claw-works/kiboard/protocol/README.md

# kiboard 协议契约

这里是 hub、agent 客户端、设备三方之间约定的**唯一真源**。
schema 在 [`schema/kiboard.schema.json`](schema/kiboard.schema.json)，本文解释为什么这么定。

schema 自己也有回归：

```bash
uvx --from jsonschema python protocol/validate.py
```

它同时喂合法样例和**故意写坏的样例**——一份"看着对但从不拒绝任何东西"的 schema
比没有更糟，因为它给人一种契约被强制执行的错觉。

> **实现状态**：本文描述的是目标契约。当前实现有一部分还没到位，
> 逐条列在最后的[实现状态](#实现状态)一节。**没标"已实现"的不要当成能用。**

## 三方职责

```
agent 客户端            hub                      设备
─────────────────      ─────────────────        ─────────────────
拦截工具调用       →   记录、标注、呈现     →   显示、收人的意思
翻译裁决为运行时       持久审计、会话态          回 accept / reject
能懂的信号         ←   回 verdict           ←   声明自己的能力
```

三条边界，越界就是设计错误：

- **hub 不裁决**。它不决定放不放行，只把"人怎么说"如实返回。**拦不拦的动作在客户端**
- **hub 不排版**。像素、键位、分页是设备的事
- **设备不理解命令语义**。它显示 hub 给的字段，不解析命令、不判风险

## 语义层与呈现层

解耦解的是**呈现层**，不是语义层。语义层必须共同认一份契约，那不是残留的耦合，那是接口。

| | 谁定 | 例子 |
|---|---|---|
| 语义层 | 本契约 | `request` / `decision` / `verdict` / `risk` / `confirm` |
| 呈现层 | 各设备自己 | 21 字符宽换行、翻页、按哪个键、点哪个像素 |

哑设备（如 c3-keypad 的早期固件）可以在 `hello` 里声明 `render: "hub"`，
让 hub 代为排版；自渲染设备声明 `render: "self"`，只收结构化字段。
**新方案一律用 `self`**，`hub` 档只为兼容存量固件保留。

## 消息

### `hello`：设备接入时声明能力

设备连上就发，hub 据此决定代不代排版、敢不敢把高危请求推给它、以及这台设备的裁决
以什么强度入账。

**如实声明是硬要求。** 声明做不到的能力，后果是 hub 把它不能安全处理的请求推给它。

```json
{
  "t": "hello",
  "protocol_version": "1.0",
  "device": { "id": "kb-01", "kind": "c3-keypad", "firmware": "v4.2.0" },
  "caps": {
    "render": "self",
    "display": { "kind": "mono", "cols": 21, "rows": 4 },
    "input": "matrix16",
    "confirm": ["tap", "hold"],
    "confirm_verifiable": true
  }
}
```

`confirm_verifiable` 是关键字段，见下面[强确认](#强确认confirm)。

### `request`：hub 推给设备的待审请求

```json
{
  "t": "request",
  "id": "r_01J8XQ2M4K",
  "verbatim": "rm -rf build",
  "tool": "execute_bash",
  "summary": "清理构建产物",
  "client": { "name": "kiro-cli", "agent": "kiboard-dev", "cwd": "/x/kiboard", "host": "mac-mini" },
  "risk": "high",
  "confirm_required": "hold",
  "rule": "递归删除",
  "expires_at": "2026-08-03T12:02:00Z"
}
```

#### required-to-display：`verbatim` 必须显示

**`verbatim` 是逐字原文，任何设备实现都必须把它显示出来，且不得被 `summary` 取代。**

`summary` 是 agent 自己写的意图说明。一个措辞良善、内容危险的 summary 会让人在错误的
前提下批准——这是实测踩过的坑（见 `clients/kiro-cli/hook-findings.md` 第 5 条）。
排版权下沉到设备之后，这条约束就只能靠协议来保证：界面漂亮优先的实现（尤其手机 App）
很自然就会只显示那句友好的 summary。

设备一致性检查里要验这一条。做不到就别声明 `render: "self"`。

### `decision`：设备回给 hub 的裁决

```json
{
  "t": "decision",
  "id": "r_01J8XQ2M4K",
  "verdict": "accept",
  "confirm": { "method": "hold", "events": [
    { "ev": "press", "device_ts": 81234 }, { "ev": "release", "device_ts": 82180 } ] }
}
```

`verdict` 取值：`accept` / `reject` / `accept_window`（开启"全部接受"窗口）/
`cancel_all`（清空队列）。

**裁决必须带 `id`。** 这是重放防护：一个隔夜的 `accept` 不能落到新请求上。
hub 收到已过期或 id 不存在的 decision 一律丢弃并记审计。

### `verdict`：hub 回给客户端的结果

```json
{
  "ok": true, "id": "r_01J8XQ2M4K",
  "decision": "accept", "approved": true,
  "reason": "user held key 1 for 946ms on kb-01",
  "risk": "high", "rule": "递归删除",
  "decided_by": { "principal": "device:kb-01", "kind": "c3-keypad",
                  "confirm": "hold", "verified_by": "hub" }
}
```

`decision` 是超集，客户端按自己的表达力降级：

| decision | 含义 | approved |
|---|---|---|
| `accept` | 人裁决批准 | true |
| `auto_accept` | 规则表 allow 档或"全部接受"窗口内 | true |
| `reject` | 人裁决拒绝 | false |
| `timeout` | 超时无人处理 | false |
| `cancelled` | 被取消，或设备离线无法展示 | false |

设备离线时 hub 返回 `503` + `cancelled`，**不把调用方吊死**——超时的裁决权留在客户端。

## 强确认（`confirm`）

高危请求不能靠一次轻点批准。但不同设备能提供的保证强度不同，**协议必须把这个差异表达出来，
不能三种设备共用一个"已强确认"的布尔值**——那等于把最弱的那条链的强度变成全局强度。

| method | 设备 | 谁验证 | 保证的是什么 |
|---|---|---|---|
| `hold` | 物理键 | **hub**（收 press/release 原始事件自己算） | 确实按住了 N 毫秒 |
| `gesture` | 触摸屏 | hub（收原始轨迹/时长） | 同上，但触摸面无触觉反馈、位置可被界面重排 |
| `biometric` | 手机 | **设备自述** | 确认了本人，**不是**确认了时长 |

原则：**能让 hub 验的就让 hub 验。** 固件是哑的，所以 `hold` 报原始事件、由 hub 计时——
这样阈值改配置就生效，不用重烧板子，而且设备说谎不了。

`biometric` 只能由设备自述，hub 验不了。所以它必须在 `verdict.decided_by.verified_by`
里如实记成 `"device"`，审计才不会撒谎。

`confirm_verifiable: false` 的设备，hub 有权拒绝把 `risk: high` 的请求推给它。

## 认证角色

统一认证，但角色必须分开：

| role | 能做 | **不能做** |
|---|---|---|
| `client` | 提交事件（审批请求、状态、任务）、查自己的 verdict、拉规则 | **提交裁决** |
| `device` | 读待审请求、提交裁决 | 提交事件 |
| `admin` | 配置、审计查询 | — |

**`client` 绝不能有提交裁决的权限。** 否则 agent 拿着客户端凭据就能自己批准自己，
整个系统归零。这是这份契约里安全收益最大的一条，也是当前实现最大的缺口
（现在 `/device` 用共享 token，见[实现状态](#实现状态)）。

## 自动放行的权限边界

hub 内部可以是黑盒，但**放行权的边界必须是白的**。

允许自动放行的只有一处：**确定性规则表的 `allow` 档**（只读命令）。

不允许的：**让模型来决定放不放行**。理由是被判定的文本本身就是攻击面——命令串和
`summary` 都是 agent 写的、可被引导的内容。"这是常规的只读检查，请自动放行"这种话，
规则表不会上当，模型会。

所以模型在 hub 里的位置是**降噪，不是放权**：

- 可以：标注、归类、排序、把命令翻译成人话、把长命令摘成一屏
- 不可以：把一条规则表判定为"要问人"的请求改成"不问人"

审计里必须记下是**哪条规则 id** 或**哪个模型 + 版本**参与了这次处理，否则出事没法追。

## 版本与兼容

`protocol_version` 用 semver，设备在 `hello` 里声明。

- 主版本不同 → hub 拒绝接入并在屏幕上说明原因，**不要降级凑合**
- 次版本新增字段 → 老设备忽略未知字段即可
- **删字段或改语义 = 主版本变更**，尤其 `verbatim` 与 `confirm` 的语义

## 实现状态

| 契约项 | 状态 |
|---|---|
| `POST /approve` `/state` `/tasks`，`GET /rules` `/audit` | 已实现 |
| 风险三档 allow / normal / high + 规则表 | 已实现 |
| 规则下发到客户端缓存、allow 档本地短路 | 已实现 |
| `hold` 由 hub 收 press/release 计时（默认 900ms） | 已实现 |
| 审计 JSONL + `GET /audit` 汇总 | 已实现 |
| 客户端 fail-closed（异常一律 exit 2） | 已实现 |
| `hello` 的 `caps` 能力声明 | 设备已发送，**hub 尚未据此分流**（只有一种设备，暂时不需要） |
| `render: "self"`（设备自渲染，hub 不排版） | **已实现**（审批屏）。查询屏 0/5/6 仍由 hub 排版 |
| `verbatim` / `summary` 作为协议字段与必显约束 | **已实现**：hub 只发字段，c3-keypad 固件负责必显 |
| `decision` / `query`：设备上报语义而非按键 | **已实现**，hub 里已无键位表 |
| `confirm.events` 原始事件 + hub 复核按住时长 | **已实现**（实测 250ms 快点被拦、按住通过） |
| 角色化认证（client 不得提交裁决） | **未实现**，当前 `/device` 单一共享 token |
| 裁决来源入审计 | **部分**：审计有 `by`（device / api），`decided_by` 的完整结构与 `verified_by` 还没有 |
| `confirm.method` 分级与 `confirm_verifiable` | **部分**：设备已声明，hub 只实现了 `hold` 一档 |
| `protocol_version` 协商 | **未实现** |

已经完成的那一步（keymap 下沉）留下三条经验，都值得写下来：

1. **超时和取消必须显式通知设备。** 只发一个"收屏"指令不够——设备那边还留着请求态
   （id、是否高危、滚动位置），下一次按键会被当成还在审批界面上。所以有了 `request_done`。
2. **裁决来源必须由裁决本身带回来。** 原先 hub 是查"最后一次按键是哪个"，语义化之后
   根本没有按键事件了，审计里的来源恒为空。手机方案上更是连键号都不存在。
3. **设备报的按住时长有个下限。** c3-keypad 的去抖冷却是 250ms，所以一次快点也会
   报成 ~250ms。阈值定在这个量级以下就没有意义了——hub 在低于 600ms 时会告警。

下一步建议：角色化认证（`client` 不得提交裁决），然后上第二个设备方案。
查询屏（0/5/6）的排版下沉可以跟着第二个方案一起做——那时才真正需要。
