claw-works/kiboard/devices/c3-keypad/hardware/bom/00.webp

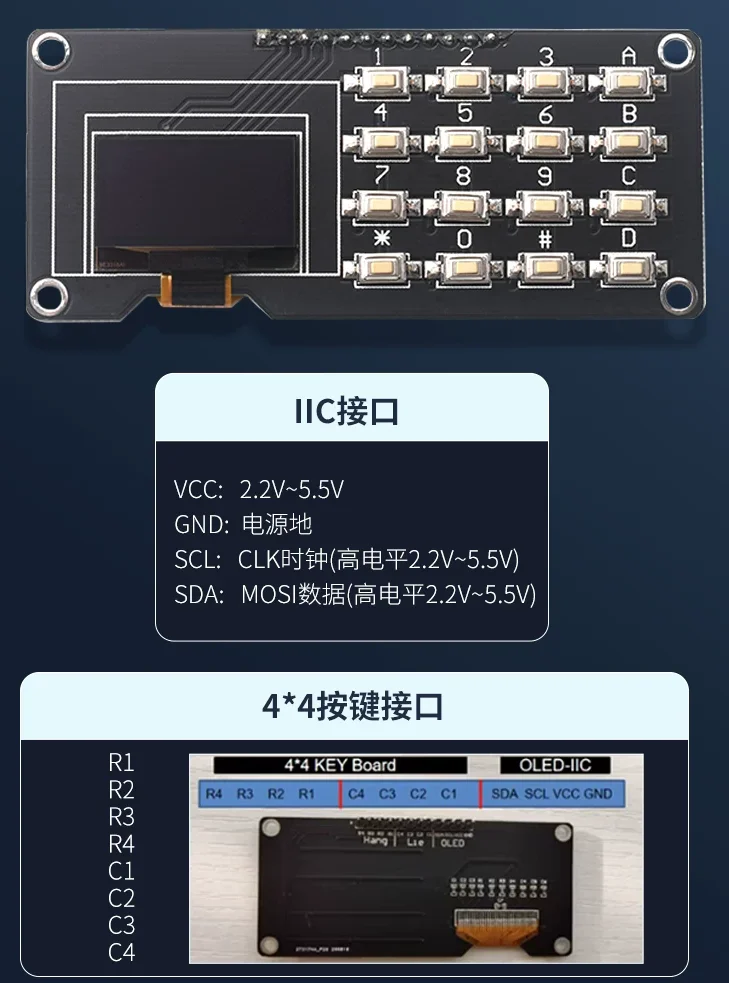
devices/c3-keypad/hardware/bom/00.webp
