claw-works/kiboard/devices/c3-keypad/hardware/bom/01.webp

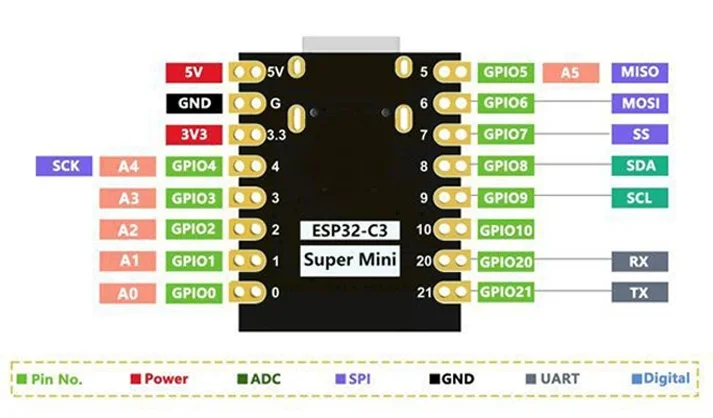
devices/c3-keypad/hardware/bom/01.webp
