claw-works/kiboard/devices/c3-keypad/hardware/kiboard/kiboard.kicad_pcb

## KiCad design hardware/schematic/SSVEP_Panel/SSVEP_Panel.kicad_sch

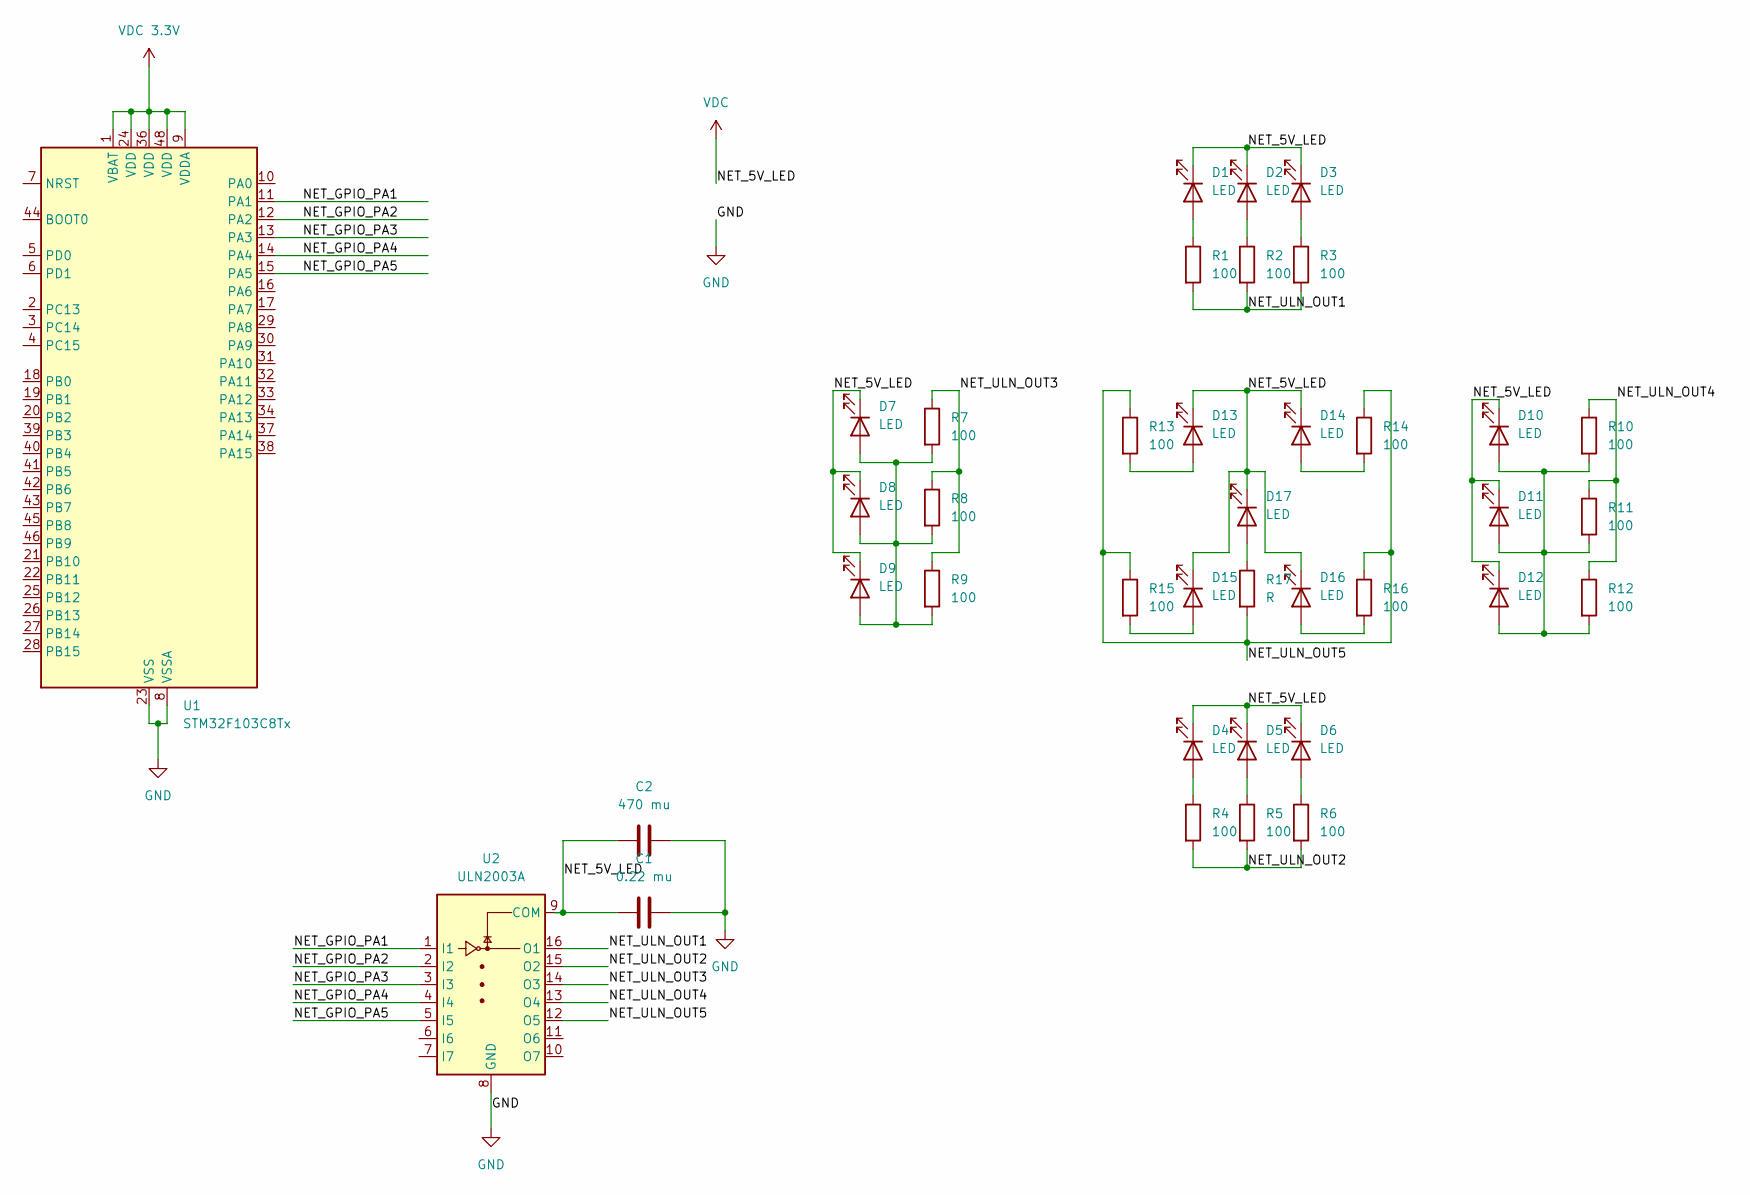
[picture p5: schematic SSVEP_Panel.kicad_sch]

Parts:
C1: 0.22 mu
C2: 470 mu
D1, D2, D3, D4, D5, D6, D7, D8, D9, D10, D11, D12, D13, D14, D15, D16, D17: LED
R1, R2, R3, R4, R5, R6, R7, R8, R9, R10, R11, R12, R13, R14, R15, R16: 100
R17: R
U1: STM32F103C8Tx; LQFP-48_7x7mm_P0.5mm
U2: ULN2003A

Connections:
GND: C1.2, C2.2, U1.8 (VSSA), U1.23 (VSS), U1.35 (VSS), U1.47 (VSS), U2.8 (GND)
NET_GPIO_PA1: U1.11 (PA1), U2.1 (I1)
NET_GPIO_PA2: U1.12 (PA2), U2.2 (I2)
NET_GPIO_PA3: U1.13 (PA3), U2.3 (I3)
NET_GPIO_PA4: U1.14 (PA4), U2.4 (I4)
NET_GPIO_PA5: U1.15 (PA5), U2.5 (I5)
NET_ULN_OUT1: R1.2, R2.2, R3.2, U2.16 (O1)
NET_ULN_OUT2: R4.2, R5.2, R6.2, U2.15 (O2)
NET_ULN_OUT3: R7.1, R8.1, R9.1, U2.14 (O3)
NET_ULN_OUT4: R10.1, R11.1, R12.1, U2.13 (O4)
NET_ULN_OUT5: R13.1, R14.1, R15.1, R16.1, R17.2, U2.12 (O5)
unnamed: D1.2 (A), R1.1
unnamed: D2.2 (A), R2.1
unnamed: D3.2 (A), R3.1
unnamed: D4.2 (A), R4.1
unnamed: D5.2 (A), R5.1
unnamed: D6.2 (A), R6.1
unnamed: D7.2 (A), D8.2 (A), D9.2 (A), R7.2, R8.2, R9.2
unnamed: D10.2 (A), D11.2 (A), D12.2 (A), R10.2, R11.2, R12.2
unnamed: D13.2 (A), R13.2
unnamed: D14.2 (A), R14.2
unnamed: D15.2 (A), R15.2
unnamed: D16.2 (A), R16.2
unnamed: D17.2 (A), R17.1
VDC: C1.1, C2.1, D1.1 (K), D2.1 (K), D3.1 (K), D4.1 (K), D5.1 (K), D6.1 (K), D7.1 (K), D8.1 (K), D9.1 (K), D10.1 (K), D11.1 (K), D12.1 (K), D13.1 (K), D14.1 (K), D15.1 (K), D16.1 (K), D17.1 (K), U2.9 (COM)
VDC 3.3V: U1.1 (VBAT), U1.9 (VDDA), U1.24 (VDD), U1.36 (VDD), U1.48 (VDD)
