claw-works/kiboard/(commit log)

2026-08-03 kiboard：agent 审批键盘（ESP32-C3 SuperMini + Rust hub）
    [kiboard.kicad_pcb, kiboard.kicad_sch]
2026-08-03 重组目录：hub 通用化，设备方案自成一体；补协议契约与威胁模型
    - devices/<方案>/ 把固件、硬件设计、方案文档放在一起：改引脚要同时动原理图和固件，
    分开放必然分叉（v3 原理图和实测固件就分叉过）。check_netlist.py 靠相对路径找固件，
    两者同时下移后代码一行没改
    - protocol/ 作为语义层唯一真源，带 schema 和回归脚本。实现状态表明确标出
    hello 能力声明、自渲染、角色认证都还没实现——没标已实现的别当能用
    - verbatim 定为 required-to-display：排版权下沉到设备后，「只显示模型写的 summary」
    这个坑只能靠协议兜住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
    [kiboard.kicad_pcb, kiboard.kicad_sch]
2026-08-03 键位与排版下沉到设备：hub 不再认识按键，删掉 keymap.rs
    hub 现在只发字段、只收语义：
    - hub -> 设备 {"t":"request","verbatim":...,"risk":...,"hold_ms":...}
    - 设备 -> hub {"t":"decision","id":N,"verdict":"accept","confirm":{events}}
    {"t":"query","what":"info|recent|last"}
    为什么这么分：键位和折行宽度是"这块板子长什么样"决定的，而 hub 要同时服务
    触摸屏和手机——那些方案上根本没有"第 3 号键"。滚动位置、翻页、没有请求时的
    提示也全部落到设备，能本地判断的就不绕一圈网络。
    强确认的分工没变松：阈值由 hub 在 request 里下发（改配置就生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
